sohamkc123/ASL-Gesture-Recognition-and-Voice-Translation-Glove/asl-glove/dataset_analysis/class_distribution_pie.png

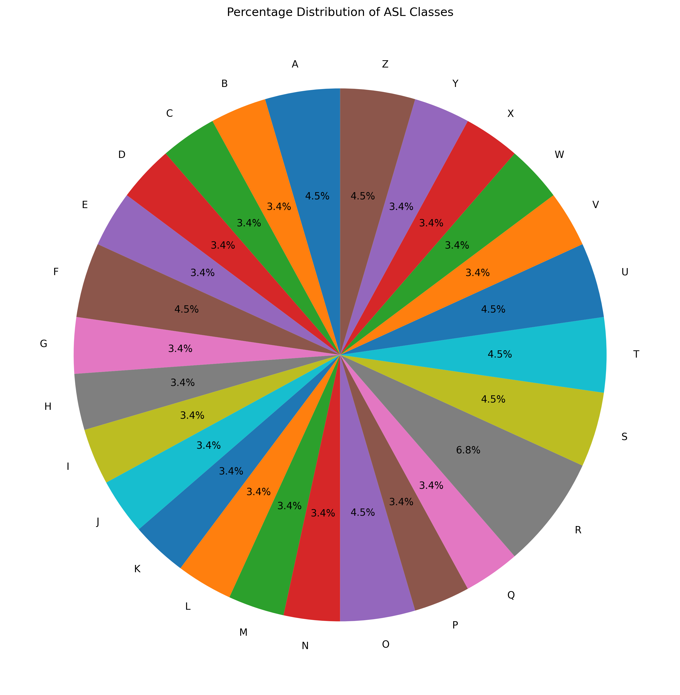
asl-glove/dataset_analysis/class_distribution_pie.png
