sohamkc123/ASL-Gesture-Recognition-and-Voice-Translation-Glove/asl-glove/report_plots/03b_training_behaviour_tinyml.png

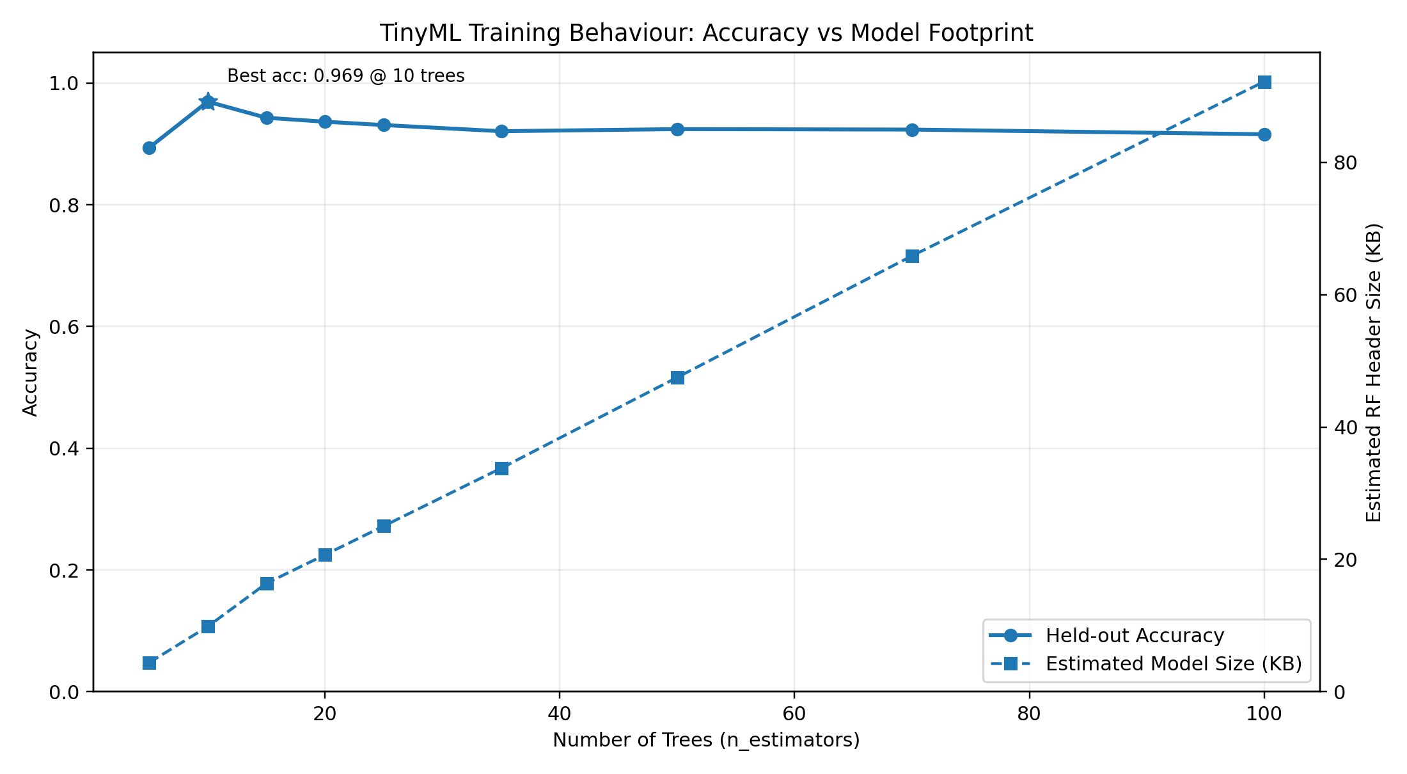
asl-glove/report_plots/03b_training_behaviour_tinyml.png
