sohamkc123/ASL-Gesture-Recognition-and-Voice-Translation-Glove/asl-glove/report_plots/06_discussion_error_breakdown.png

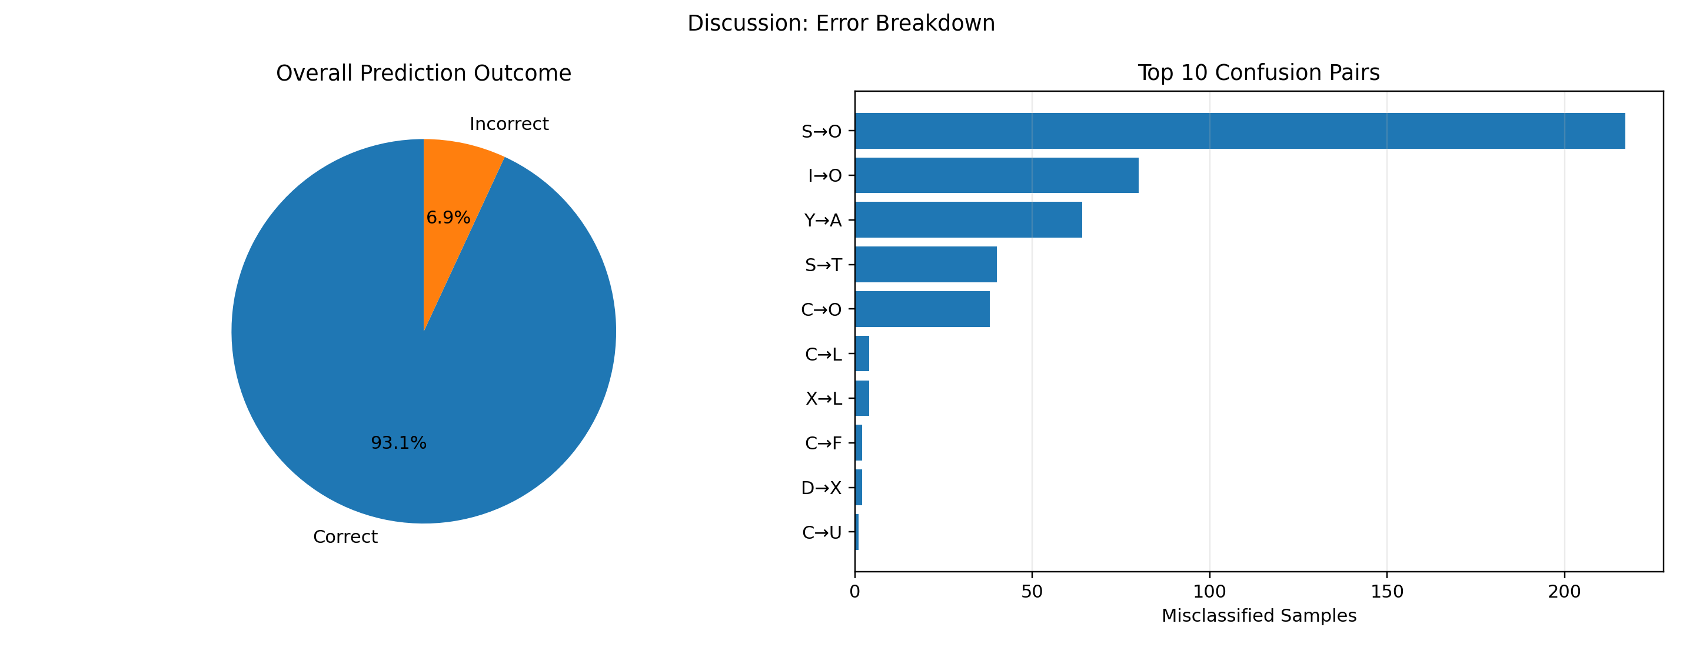
asl-glove/report_plots/06_discussion_error_breakdown.png
