sohamkc123/ASL-Gesture-Recognition-and-Voice-Translation-Glove/asl-glove/report_plots/circuit_diagram_compact.png

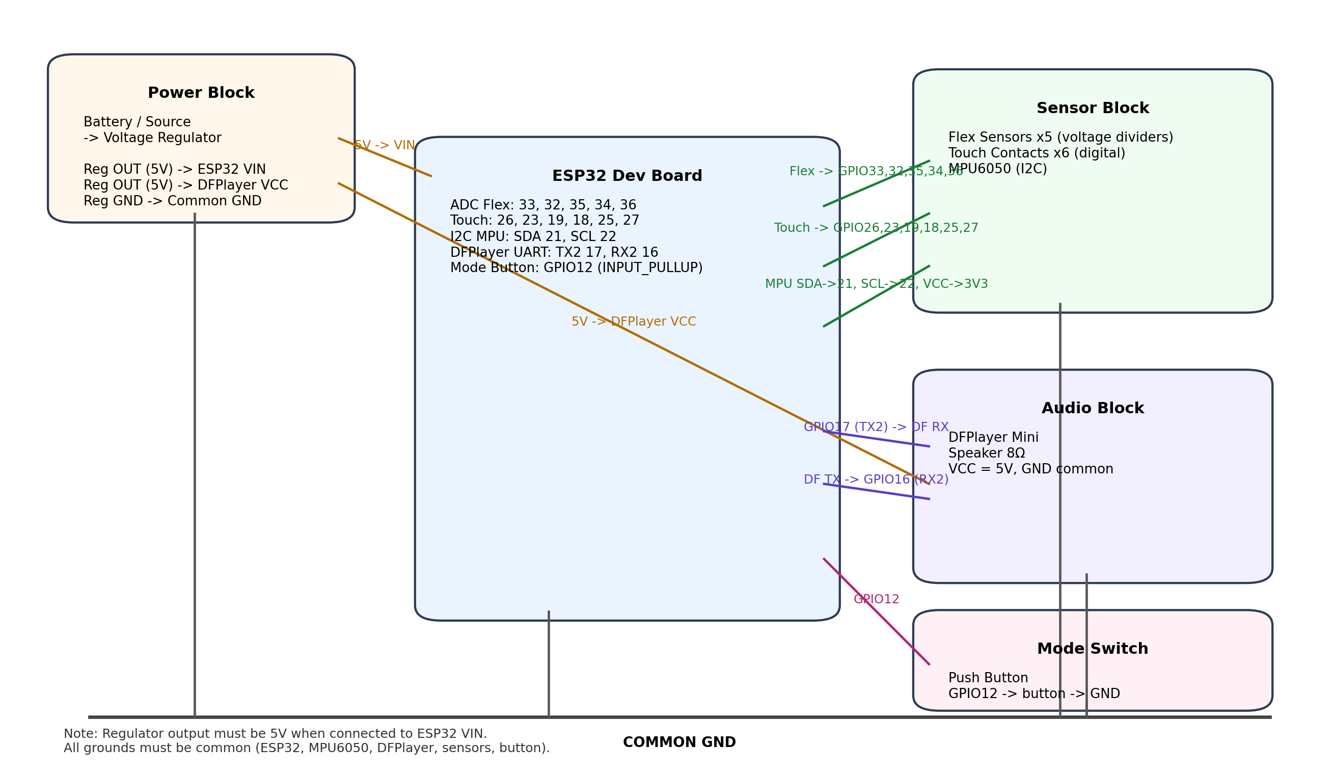
asl-glove/report_plots/circuit_diagram_compact.png
