sohamkc123/ASL-Gesture-Recognition-and-Voice-Translation-Glove/asl-glove/dataset_analysis/test_dataset.csv

flex_pinky | flex_ring | flex_middle | flex_index | flex_thumb | touch_index | touch_middle | touch_ring | touch_pinky | touch_r | touch_u | ax | ay | az | gx | gy | gz | label | rep | session | day
1.0 | 0.8989391401451703 | 0.931095406360424 | 0.8528610354223434 | 0.0699300699300699 | 1.0 | 1.0 | 1.0 | 1.0 | 1.0 | 0.0 | 0.5543212890625 | 0.055419921875 | -0.023193359375 | -0.00140380859375 | -0.010528564453125 | -0.0089111328125 | A | 0 | 2026-08-25_07-56-39 | 2026-08-25
1.0 | 0.897822445561139 | 0.9558303886925796 | 0.9618528610354224 | 0.0909090909090909 | 1.0 | 1.0 | 1.0 | 1.0 | 1.0 | 0.0 | 0.5543212890625 | 0.0745849609375 | -0.0186767578125 | -0.017974853515625 | -0.002349853515625 | -0.008758544921875 | A | 0 | 2026-08-25_07-56-39 | 2026-08-25
1.0 | 0.8944723618090452 | 0.9363957597173144 | 0.896457765667575 | 0.0279720279720279 | 1.0 | 1.0 | 1.0 | 1.0 | 1.0 | 0.0 | 0.5584716796875 | 0.0777587890625 | -0.01123046875 | -0.01983642578125 | -0.00555419921875 | -0.0037841796875 | A | 0 | 2026-08-25_07-56-39 | 2026-08-25
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
