sohamkc123/ASL-Gesture-Recognition-and-Voice-Translation-Glove/asl-glove/dataset_analysis/train_test_class_distribution.png

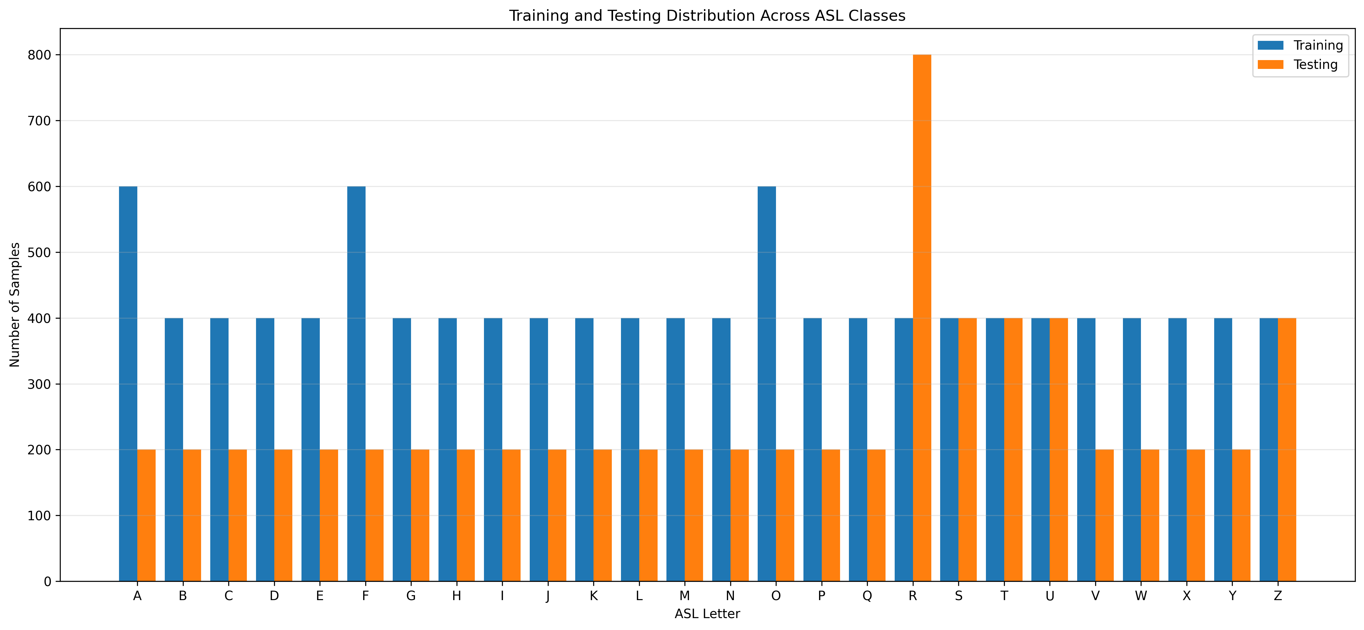
asl-glove/dataset_analysis/train_test_class_distribution.png
