sohamkc123/ASL-Gesture-Recognition-and-Voice-Translation-Glove/asl-glove/report_plots/04_per_class_performance.png

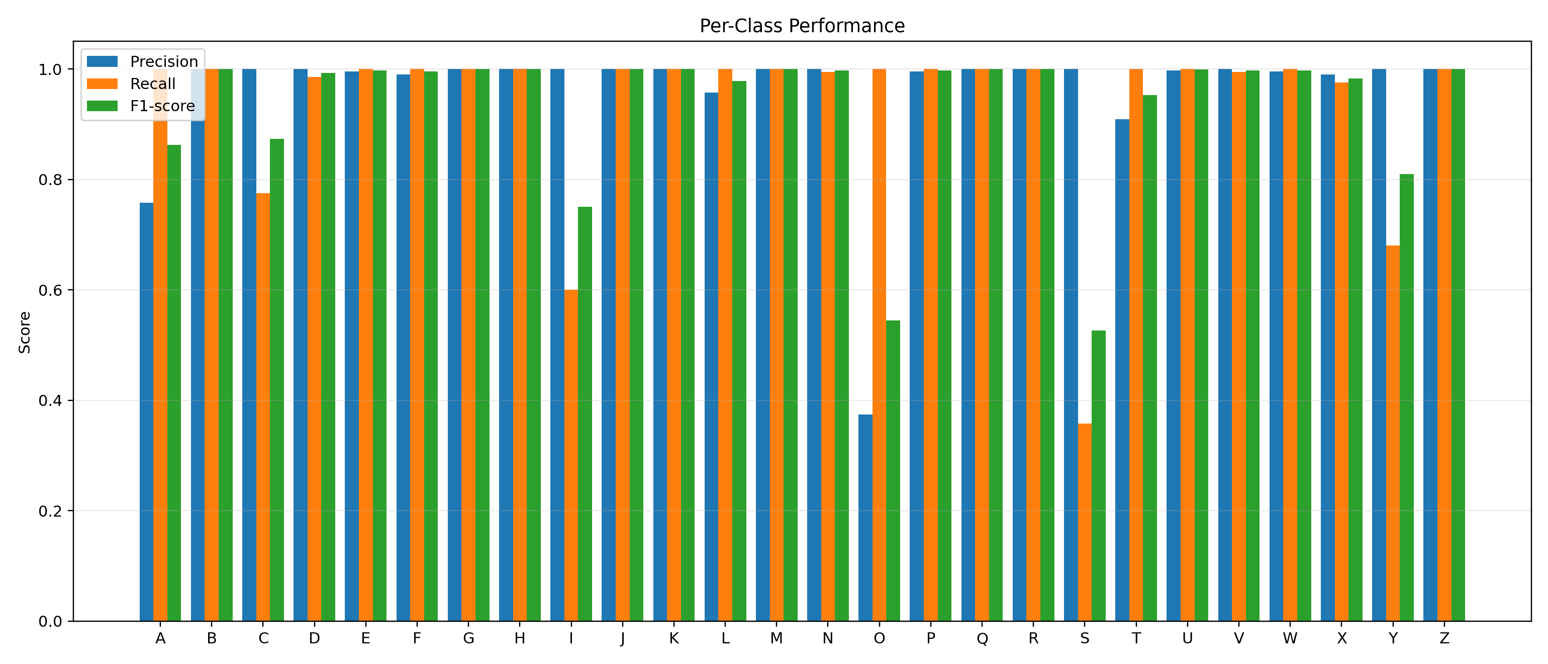
asl-glove/report_plots/04_per_class_performance.png
