sohamkc123/ASL-Gesture-Recognition-and-Voice-Translation-Glove/asl-glove/esp32/rf_model_deploy/model_deploy_rf/rf_model.h

#ifndef RF_MODEL_H
#define RF_MODEL_H

#include <stdint.h>

typedef struct {
  int16_t feature;
  float threshold;
  int16_t left;
  int16_t right;
  int16_t pred;
} RFNode;

typedef struct {
  const RFNode* nodes;
  uint16_t node_count;
} RFTree;

static const RFNode RF_TREE_0[] = {
  {9, 0.5000000f, 1, 6, -1},
  {13, 0.1315918f, 2, 5, -1},
  {10, 0.5000000f, 3, 4, -1},
  {-1, 0.0000000f, -1, -1, 9},
  {-1, 0.0000000f, -1, -1, 17},
  {-1, 0.0000000f, -1, -1, 9},
  {11, -0.1300659f, 7, 8, -1},
  {-1, 0.0000000f, -1, -1, 16},
  {2, 0.6267325f, 9, 34, -1},
  {12, -0.3131104f, 10, 11, -1},
  {-1, 0.0000000f, -1, -1, 7},
  {3, 0.5328727f, 12, 31, -1},
  {13, 0.0690918f, 13, 30, -1},
  {0, 0.5818301f, 14, 21, -1},
  {14, 0.0542450f, 15, 20, -1},
  {14, -0.0405579f, 16, 17, -1},
  {-1, 0.0000000f, -1, -1, 1},
  {5, 0.5000000f, 18, 19, -1},
  {-1, 0.0000000f, -1, -1, 5},
  {-1, 0.0000000f, -1, -1, 1},
  {-1, 0.0000000f, -1, -1, 5},
  {1, 0.8712934f, 22, 23, -1},
  {-1, 0.0000000f, -1, -1, 22},
  {3, 0.0757406f, 24, 27, -1},
  {2, 0.3485577f, 25, 26, -1},
  {-1, 0.0000000f, -1, -1, 21},
  {-1, 0.0000000f, -1, -1, 20},
  {8, 0.5000000f, 28, 29, -1},
  {-1, 0.0000000f, -1, -1, 22},
  {-1, 0.0000000f, -1, -1, 20},
  {-1, 0.0000000f, -1, -1, 10},
  {13, -0.1556396f, 32, 33, -1},
  {-1, 0.0000000f, -1, -1, 5},
  {-1, 0.0000000f, -1, -1, 5},
  {8, 0.5000000f, 35, 42, -1},
  {13, -0.0378418f, 36, 39, -1},
  {5, 0.5000000f, 37, 38, -1},
  {-1, 0.0000000f, -1, -1, 4},
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
  {-1, 0.0000000f, -1, -1, 4},
  {11, 0.5551147f, 33, 34, -1},
  {-1, 0.0000000f, -1, -1, 12},
  {11, 0.5552368f, 35, 36, -1},
  {-1, 0.0000000f, -1, -1, 12},
  {-1, 0.0000000f, -1, -1, 12},
  {3, 0.3713961f, 38, 47, -1},
  {1, 0.3151419f, 39, 40, -1},
  {-1, 0.0000000f, -1, -1, 1},
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
};
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
