sohamkc123/ASL-Gesture-Recognition-and-Voice-Translation-Glove/asl-glove/esp32/model deploy/model_deploy/calibration.h

#ifndef CALIBRATION_H
#define CALIBRATION_H

// Generated from calibration_2026-08-26_17-23-52.json
// Order: pinky, ring, middle, index, thumb (matches FEATURE_NAMES)

const float flex_flat[5] = {1155.00f, 990.00f, 848.00f, 244.00f, 2538.00f};
const float flex_fist[5] = {289.00f, 332.50f, 321.00f, 95.00f, 2399.00f};

#endif
