sohamkc123/ASL-Gesture-Recognition-and-Voice-Translation-Glove/(commit log)

2026-08-15 datacollection and model training initial
    [asl_dataset.csv]
2026-08-15 dataset taken by sarthak hand from h but in different csv file
    [asl_dataset.csv]
2026-08-15 Add combined ASL alphabet dataset
    [ASL_combined_AZ_sorted.csv]
2026-08-15 made the ino code to speak through dfplayer rather than print in serial monitor(problem: only says W)
    [collect_data.py, model_data.h, model_deploy.ino]
2026-08-22 data taken as per new pipline
    [asl_dataset_cleaned.csv, session_2026-08-22_23-06-48.csv]
2026-08-31 Updated model training and deployment ; final report remaining to commit
    [ASL_Gesture_Dataset_Cleaned.csv, ASL_combined_AZ_sorted.csv, asl_dataset.csv, asl_dataset_cleaned.csv, class_distribution.csv, combined_dataset.csv, session_2026-08-22_23-06-48.csv, session_2026-08-23_09-51-49.csv]
2026-09-01 Rename Print Final.pdf to Report.pdf
